bailinphil/kitchen-lights/wiring/kitchen-lights-wiring.kicad_pcb

## KiCad design STM32_KiCAD_Bluetooth/STM32_KiCAD_Bluetooth.kicad_sch

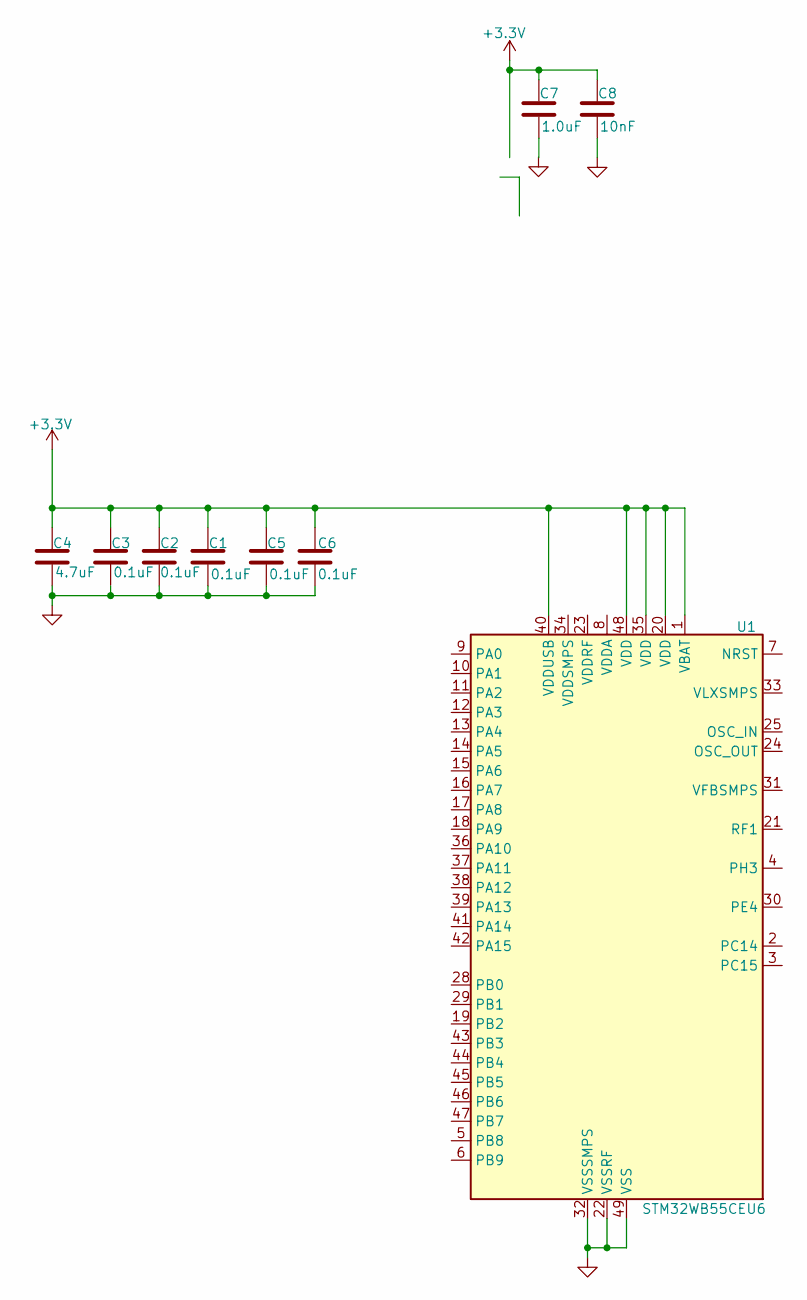
[picture p1: schematic STM32_KiCAD_Bluetooth.kicad_sch]

Parts:
C1, C2, C3, C5, C6: 0.1uF; C_0603_1608Metric; Voltage 25V; Tolerance 20%
C4: 4.7uF; C_0603_1608Metric; Voltage 35V; Tolerance 20%
C7: 1.0uF; C_0603_1608Metric; Voltage 16V; Tolerance 10%
C8: 10nF; C_0603_1608Metric; Voltage 16V; Tolerance 10%
U1: STM32WB55CEU6; QFN-48-1EP_7x7mm_P0.5mm_EP5.6x5.6mm

Connections:
+3.3V: C1.1, C2.1, C3.1, C4.1, C5.1, C6.1, C7.1, C8.1, U1.1 (VBAT), U1.20 (VDD), U1.35 (VDD), U1.40 (VDDUSB), U1.48 (VDD)
GND: C1.2, C2.2, C3.2, C4.2, C5.2, C6.2, C8.2, U1.22 (VSSRF), U1.32 (VSSSMPS), U1.49 (VSS)
