bailinphil/kitchen-lights/src/lights/licenses.h

#ifndef KITCHEN_LIGHTS_LICENSES_H_
#define KITCHEN_LIGHTS_LICENSES_H_

/*
 * LCD
 *
 * Sample Code Original Header
 *
 */

/*
 OpenLCD is an LCD with Serial/I2C/SPI interfaces.
 By: Nathan Seidle
 SparkFun Electronics
 Date: April 19th, 2015
 License: This code is public domain but you buy me a beer if you use this and we meet someday (Beerware license).
 This is example code that shows how to send data over I2C to the display.
 Note: This code expects the display to be listening at the default I2C address. If your display is not at 0x72, you can
 do a hardware reset. Tie the RX pin to ground and power up OpenLCD. You should see the splash screen
 then "System reset Power cycle me" and the backlight will begin to blink. Now power down OpenLCD and remove
 the RX/GND jumper. OpenLCD is now reset.
 To get this code to work, attached an OpenLCD to an Arduino Uno using the following pins:
 SCL (OpenLCD) to A5 (Arduino)
 SDA to A4
 VIN to 5V
 GND to GND
 Command cheat sheet:
 ASCII / DEC / HEX
 '|'    / 124 / 0x7C - Put into setting mode
 Ctrl+c / 3 / 0x03 - Change width to 20
 Ctrl+d / 4 / 0x04 - Change width to 16
 Ctrl+e / 5 / 0x05 - Change lines to 4
 Ctrl+f / 6 / 0x06 - Change lines to 2
 Ctrl+g / 7 / 0x07 - Change lines to 1
 Ctrl+h / 8 / 0x08 - Software reset of the system
 Ctrl+i / 9 / 0x09 - Enable/disable splash screen
 Ctrl+j / 10 / 0x0A - Save currently displayed text as splash
 Ctrl+k / 11 / 0x0B - Change baud to 2400bps
 Ctrl+l / 12 / 0x0C - Change baud to 4800bps
 Ctrl+m / 13 / 0x0D - Change baud to 9600bps
 Ctrl+n / 14 / 0x0E - Change baud to 14400bps
 Ctrl+o / 15 / 0x0F - Change baud to 19200bps
 Ctrl+p / 16 / 0x10 - Change baud to 38400bps
 Ctrl+q / 17 / 0x11 - Change baud to 57600bps
 Ctrl+r / 18 / 0x12 - Change baud to 115200bps
 Ctrl+s / 19 / 0x13 - Change baud to 230400bps
 Ctrl+t / 20 / 0x14 - Change baud to 460800bps
 Ctrl+u / 21 / 0x15 - Change baud to 921600bps
 Ctrl+v / 22 / 0x16 - Change baud to 1000000bps
 Ctrl+w / 23 / 0x17 - Change baud to 1200bps
 Ctrl+x / 24 / 0x18 - Change the contrast. Follow Ctrl+x with number 0 to 255. 120 is default.
 Ctrl+y / 25 / 0x19 - Change the TWI address. Follow Ctrl+x with number 0 to 255. 114 (0x72) is default.
 Ctrl+z / 26 / 0x1A - Enable/disable ignore RX pin on startup (ignore emergency reset)
 '-'    / 45 / 0x2D - Clear display. Move cursor to home position.
        / 128-157 / 0x80-0x9D - Set the primary backlight brightness. 128 = Off, 157 = 100%.
        / 158-187 / 0x9E-0xBB - Set the green backlight brightness. 158 = Off, 187 = 100%.
        / 188-217 / 0xBC-0xD9 - Set the blue backlight brightness. 188 = Off, 217 = 100%.
 For example, to change the baud rate to 115200 send 124 followed by 18.
*/

/*
  LiquidCrystal Library - Custom Characters

 Demonstrates how to add custom characters on an LCD  display.
 The LiquidCrystal library works with all LCD displays that are
 compatible with the  Hitachi HD44780 driver. There are many of
 them out there, and you can usually tell them by the 16-pin interface.

 This sketch prints "I <heart> Arduino!" and a little dancing man
 to the LCD.

  The circuit:
 * LCD RS pin to digital pin 12
 * LCD Enable pin to digital pin 11
 * LCD D4 pin to digital pin 5
 * LCD D5 pin to digital pin 4
 * LCD D6 pin to digital pin 3
 * LCD D7 pin to digital pin 2
 * LCD R/W pin to ground
 * 10K potentiometer:
 * ends to +5V and ground
 * wiper to LCD VO pin (pin 3)
 * 10K poterntiometer on pin A0

 created 21 Mar 2011
 by Tom Igoe
 modified 11 Nov 2013
 by Scott Fitzgerald
 modified 7 Nov 2016
 by Arturo Guadalupi

 Based on Adafruit's example at
 https://github.com/adafruit/SPI_VFD/blob/master/examples/createChar/createChar.pde

 This example code is in the public domain.
 http://www.arduino.cc/en/Tutorial/LiquidCrystalCustomCharacter

 Also useful:
 http://icontexto.com/charactercreator/

*/


/*
 * SparkFun Qwiic Twist
 *
 * Sample code original header
 *
 */
/*
  Read and interact with the SparkFun Qwiic Twist digital RGB encoder
  By: Nathan Seidle
  SparkFun Electronics
  Date: December 3rd, 2018
  License: MIT. See license file for more information but you can
  basically do whatever you want with this code.

  This example shows how to set the knob color to pink. This value is stored in the 
  Qwiic Twist and will be loaded after each power-on.

  Also - the max I2C datarate for Qwiic Twist is 400kHz
  
  Feel like supporting open source hardware?
  Buy a board from SparkFun! https://www.sparkfun.com/products/15083

  Hardware Connections:
  Plug a Qwiic cable into the Qwiic Twist and a BlackBoard
  If you don't have a platform with a Qwiic connection use the SparkFun Qwiic Breadboard Jumper (https://www.sparkfun.com/products/14425)
  Open the serial monitor at 115200 baud to see the output
*/


/**
 * BasicHTTPClient.ino
 *
 *  Created on: 24.05.2015
 *
 */

 /*
 * I2C-Generator: 0.3.0
 * Yaml Version: 2.1.3
 * Template Version: 0.7.0-112-g190ecaa
 */
/*
 * Copyright (c) 2021, Sensirion AG
 * All rights reserved.
 *
 * Redistribution and use in source and binary forms, with or without
 * modification, are permitted provided that the following conditions are met:
 *
 * * Redistributions of source code must retain the above copyright notice, this
 *   list of conditions and the following disclaimer.
 *
 * * Redistributions in binary form must reproduce the above copyright notice,
 *   this list of conditions and the following disclaimer in the documentation
 *   and/or other materials provided with the distribution.
 *
 * * Neither the name of Sensirion AG nor the names of its
 *   contributors may be used to endorse or promote products derived from
 *   this software without specific prior written permission.
 *
 * THIS SOFTWARE IS PROVIDED BY THE COPYRIGHT HOLDERS AND CONTRIBUTORS "AS IS"
 * AND ANY EXPRESS OR IMPLIED WARRANTIES, INCLUDING, BUT NOT LIMITED TO, THE
 * IMPLIED WARRANTIES OF MERCHANTABILITY AND FITNESS FOR A PARTICULAR PURPOSE
 * ARE DISCLAIMED. IN NO EVENT SHALL THE COPYRIGHT HOLDER OR CONTRIBUTORS BE
 * LIABLE FOR ANY DIRECT, INDIRECT, INCIDENTAL, SPECIAL, EXEMPLARY, OR
 * CONSEQUENTIAL DAMAGES (INCLUDING, BUT NOT LIMITED TO, PROCUREMENT OF
 * SUBSTITUTE GOODS OR SERVICES; LOSS OF USE, DATA, OR PROFITS; OR BUSINESS
 * INTERRUPTION) HOWEVER CAUSED AND ON ANY THEORY OF LIABILITY, WHETHER IN
 * CONTRACT, STRICT LIABILITY, OR TORT (INCLUDING NEGLIGENCE OR OTHERWISE)
 * ARISING IN ANY WAY OUT OF THE USE OF THIS SOFTWARE, EVEN IF ADVISED OF THE
 * POSSIBILITY OF SUCH DAMAGE.
 */

 /*
  Reading CO2, humidity and temperature from the SCD4x
  By: Paul Clark
  Based on earlier code by: Nathan Seidle
  SparkFun Electronics
  Date: June 3rd, 2021
  License: MIT. See license file for more information but you can
  basically do whatever you want with this code.

  Feel like supporting open source hardware?
  Buy a board from SparkFun! https://www.sparkfun.com/products/18365

  This example prints the current CO2 level, relative humidity, and temperature in C.

  Hardware Connections:
  Attach RedBoard to computer using a USB cable.
  Connect SCD40/41 to RedBoard using Qwiic cable.
  Open Serial Monitor at 115200 baud.
*/

/******************************************************************************
  Example1_BasicReadings.ino
  
  Read human presence detection values from the STHS34PF80 sensor, print them
  to terminal. Prints raw IR presence (cm^-1), if motion was detected, and 
  temperature in degrees C.

  SparkFun STHS34PF80 Arduino Library
  Madison Chodikov @ SparkFun Electronics
  Original Creation Date: September 19th, 2023
  https://github.com/sparkfun/SparkFun_STHS34PF80_Arduino_Library

  Development environment specifics:

  IDE: Arduino 2.2.1
  Hardware Platform: SparkFun RedBoard Qwiic	
  SparkFun Human Presence and Motion Sensor - STHS34PF80 (Qwiic) Version: 1.0
  SparkFun Qwiic Mini Human Presence and Motion Sensor - STHS34PF80 Version: 1.0

  Do you like this library? Help support SparkFun. Buy a board!

    SparkFun Human Presence and Motion Sensor - STHS34PF80 (Qwiic)
    https://www.sparkfun.com/products/22494
    
    SparkFun Qwiic Mini Human Presence and Motion Sensor - STHS34PF80
    https://www.sparkfun.com/products/23253

  Hardware Connections:
  Use a Qwiic cable to connect from the RedBoard Qwiic to the STHS34PF80 breakout (QWIIC).
  You can also choose to wire up the connections using the header pins like so:

  ARDUINO --> STHS34PF80
  SDA (A4) --> SDA
  SCL (A5) --> SCL
  3.3V --> 3.3V
  GND --> GND

  This program is distributed in the hope that it will be useful,
  but WITHOUT ANY WARRANTY; without even the implied warranty of
  MERCHANTABILITY or FITNESS FOR A PARTICULAR PURPOSE. See the
  GNU General Public License for more details.

  You should have received a copy of the GNU General Public License
  along with this program.  If not, see <http://www.gnu.org/licenses/>.
******************************************************************************/

#endif  // KITCHEN_LIGHTS_LICENSES_H_
