bailinphil/kitchen-lights/(commit log)

2025-01-25 initial project setup, including some Arduino code which runs simple exercises on a SparkFun ESP32 IoT Redboard
    [kitchen-lights-wiring.kicad_pcb, kitchen-lights-wiring.kicad_sch]
2025-01-26 added some logic to color the twist wheel orange as you turn it.
2025-01-29 fetch the current time in UTC
    The WiFi example code in the library included an example of fetching
    the current time from time.nist.gov. I modified this to fetch from
    time.google.com instead, and I moved the network credentials to a
    separate file to avoid committing them to the repository.
    This example seems to take up about 70% of the available storage on
    my device; I hope that the other libraries I want to use don't make
    it take up more than I have available! Or that I can use the SD
    card slot to store a larger program on my device.
    [get_time.ino]
2025-02-15 ignore the Arduino/libraries directory
2025-02-17 rename Arduino directory as src; move existing prototype and example code to a references/ folder within src.
2025-02-17 Specify correct color order for my particular LEDs.
    [two_light_outputs.ino]
2025-02-17 begin to lay out actual project code
    up until now, I have been working with a number of examples and simple demos
    of each individual component of the system. Now it is time to begin working
    on the real interface and behavior that the final installation will have,
    featuring:
    1. Mode selection dial with 10 positions
    2. Qwiic Twist for various knob-and-button-based adjustments
    3. Internet connection to get time, save and fetch custom adjustments
    4. Human presence sensor to time the lights out when no one is there
    5. 16x2 LCD display to communicate status and other information
    6. Air quality metrics
    A. Logging the data to my personal web server.
    7. I am considering a photoresistor to se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
2025-02-17 WiFi IPV6 code which fetches the time
    This code works as is, but includes some very long delays, which
    means that all of the other inputs on the rotary switch and the
    twist have a ~10s wait to see the result. Obviously, this won't
    do.
    The next step is to redesign the WiFi loop function to always
    end quickly and check the elapsed time instead of forcing the
    main thread to idle for long periods.
    [lights.ino]
2025-02-18 Fetch, parse, display weather data. Don't flicker the LCD.
    This update hits an endpoint on my personal web server which
    periodically fetches current weather data and prepares it for display on
    the 16x2. The RedBoard will go fetch that file, parse it, and
    rotate through the info that it wants to report.
2025-12-20 add human presence sensor to the i2c chain, make it active during night mode
2025-12-20 add example for using MicroSD card slot on IoT RedBoard
2025-12-21 Track 2 previous mode values and use them to ignore analog noise.
    While testing "night" mode, I noticed that occasionally the lights
    would flicker briefly because they were flashing for one moment into
    a mode with nearby adjacent analog values for the switch. That is,
    every once in a while the analog read values for the switch would be
    slightly out of range. In order to resolve this, I keep a small
    buffer of the previous two readings. This allows me to ignore an
    isolated value which is out of range and doesn't reflect an actual
    switch.
    [lights.ino]
2025-12-21 Begin taking readings with the SEN-25200 indoor air quality sensor.
    This code is lifted verbatim from the examples provided with the
    arduino library for the sensor.
2025-12-27 Implement a "sliding window" brightness control
    The Twist Rotational input can boot up with "any" value to start.
    As you spin the dial, the original algorithm was computing brightness
    and then limiting it to 0-255. But you could keep going outside of
    the range, and you couldn't go the opposite direction until you
    went all the way back to within the range.
    This is solved by making a sliding window: if you are already at
    the maximum brightness, turning the dial clockwise will slide the
    window up. So when you turn the dial counterclockwise, the brightness
    will immediately start to reduce. This feels more intuitive.
    [licenses.h, lights.ino]
2025-12-28 Talk to a third pin of lights. This was mostly wiring work.
2026-03-12 Refactor lights.ino for readability without functional changes
    - Reformat modeName[], twist_colors[][], and modeColor[] arrays with
    consistent indentation, trailing commas, and inline mode-name comments
    so the three parallel arrays are easy to read and cross-reference
    - Extract updateTwistWindow() and applyNightFade() helpers from loop()
    to give descriptive names to the two dense logic blocks there
    - Simplify checkPresence() with early returns, removing the redundant
    local `result` variable
    - Rename shadowing local `presenceVal` in loop() to `detectedPresence`
    - Make getSwitchPosition() consistent: declare variables at top, assign
    val before color in every branch
    - Fix charsPrinted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
    [lights.ino]
2026-03-12 Rename helpers and reorganize into labeled subsystem sections
    Renames:
    - setup16x2 → setupDisplay
    - setupSensiron41 → setupCO2Sensor
    - setupSensiron55 → setupParticulateSensor
    - loopAirQuality → reportAirQuality
    - i2cSendValue → updateDisplay
    - fill → setAllLEDs
    - updateTwistWindow → clampTwistWindow
    Layout (top to bottom):
    1. SETUP – setup() + all setupX() helpers + printSerialNumber/printModuleVersions
    (diagnostic print helpers moved next to the setup code that calls them)
    2. LOOP – loop() entry point
    3. DISPLAY – prepareTopMessage, prepareBottomMessage, updateDisplay
    4. LEDS – setAllLEDs
    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
2026-03-14 wrap air quality sensor-related code in #define to allow disconnection
    add a series of #define directives which allow me to compile the code with any of the hardware devices connected or disabled.
    Let's start by making a #define called IS_AIR_SENSOR_PRESENT which I can give a value of true or false to. If it is true, I want the corresponding setup functions (setupC02Sensor, setupParticulateSensor) to be enabled. otherwise, skip them.
    Likewise, in the main loop() I want all of the code which checks for how long it's been since an air report to be enabled or disabled by IS_AIR_SENSOR_PRESENT.
    [lights.ino]
2026-03-15 Create constant for mode switch pin, turn twist back on for testing.
2026-03-15 Add a #define to disable the presence sensor
2026-03-15 add a #define to disable the LEDs
2026-03-15 working on solving a problem with serial output.
    1. try activating and deactivating various components
    - Currently, if WiFi is enabled but FastLED is not, we get an
    exception that I don't understand yet.
    2. I've connected the problem with Serial output with FastLED.
    - https://forum.arduino.cc/t/fastled-causes-serial-data-corruption-thoughts/669299/6
    - I made a first (flawed) attempt to follow the advice in there of
    not calling FastLED.show() more than necessary. It helps, by
    reducing the spam to the Serial connection. However, the other
    calls to Serial.println() are still not getting through.
    [lights.ino]
2026-03-15 Move FastLED communication off of the default Serial I/O pins.
    Response from Claude when I had asked it for assistance with debugging:
    Looking at the code, I think there's a **direct hardware conflict** that's almost certainly the smoking gun here. Let me point it out:
    ```cpp
    FastLED.addLeds<CHIPSET, 3, COLOR_ORDER>(leds, NUM_LEDS);
    FastLED.addLeds<CHIPSET, 1, COLOR_ORDER>(leds, NUM_LEDS); // ← PIN 1
    FastLED.addLeds<CHIPSET, 4, COLOR_ORDER>(leds, NUM_LEDS);
    ```
    On the ESP32, the default hardware serial pins are:
    - **GPIO 1 = TX** (Serial transmit)
    - **GPIO 3 = RX** (Serial receive)
    You're driving two of your three LED strips on **pins 1 and 3** — the exact same pins that `Serial` us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
2026-03-16 Fix several bugs likely causing the 16x2 display to freeze after hours of uptime
    - Fix off-by-one in prepareBottomMessage: `> WEATHER_REPORT_MAX_LENGTH` should
    be `>=`, otherwise weatherReport[10] is accessed out-of-bounds every ~30s,
    causing repeated heap corruption that accumulates over time.
    - Add bounds check in parseWeatherReport to prevent writing past the end of
    the weatherReport array if the server returns more tokens than expected.
    - Fix millisWhenBottomRowUpdated declared as int instead of unsigned long;
    it stores the return value of millis() and would overflow after ~24.8 days.
    - Move millisWhenWeatherLastFetched update outside the HTTP_CODE_OK check so
    failed fetches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
    [lights.ino]
2026-03-17 Implement the de-noise logic for mode switch as a delay time instead of majority vote.
    This addresses [Issue #12](https://github.com/bailinphil/kitchen-lights/issues/12).
    [lights.ino]
2026-03-17 Guard the assignment of isLedDirty inside of #IS_FASTLED_ENABLED
    This (and 8eddfa8f20aef20f791faede2df0a60ab81cb570) address https://github.com/bailinphil/kitchen-lights/issues/1
    [lights.ino]
2026-03-17 Add multi-region LED setup for under-cabinet and ceiling runs
    Replace the single shared LED array with per-pin arrays and named
    region constants (placeholder sizes) for under-cabinet sections
    (pin 25) and ceiling sections (pins 17, 16). Under-cabinet and
    ceiling pin 17 are reversed in software to allow logical left-to-right
    addressing despite right-to-left wiring. The ceiling strips are
    treated as one continuous run so future animations can flow seamlessly
    across both pins.
    Closes #3
    [lights.ino]
2026-03-17 Implement Rainbow mode replacing Racetrack
    Rename mode index 7 from "Racetrack" to "Rainbow" and add a
    continuously animated effect that propagates fully-saturated colors
    left-to-right across both the under-cabinet and ceiling runs.
    - Each loop iteration, shift all LEDs one position right and inject
    the current hue at the leftmost end (~3 second full traversal).
    - Ceiling crossover: pin 17 flows seamlessly into pin 16.
    - Twist knob controls hue instead of brightness while in Rainbow mode.
    - Twist button toggles between auto-cycling hue and manual selection.
    - Entering Rainbow mode picks a random starting hue and clears strips.
    Closes #8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
2026-03-17 Fix Rainbow mode compile error: use committedSwitchPosition for twist button
    The twist button press handler runs before getDebouncedSwitchPosition(),
    so nextSwitchPosition is not yet declared. Use the already-committed
    global instead.
    [lights.ino]
2026-03-17 Implement Twinkle mode with spawn collision avoidance and blue-green palette
    Twinkle mode (index 8) spawns random colored spots that fade in, spread
    to neighbors, then decay via global fadeToBlackBy. Palette is limited to
    blue-green hues to avoid jarring clashes between adjacent spots. New
    spawns avoid positions near still-bright active spots. Twist knob
    controls spawn rate (2-30/sec), twist button (isClicked) toggles
    monochrome vs multi-color.
    Closes #9
    [lights.ino]
2026-03-18 Implement Fire mode replacing Sparkles with heat-map fire simulation
    Add a heat-diffusion fire effect on mode index 6. Each strip maintains
    a heat array that cools, drifts upward, and randomly sparks near the
    source end each frame. Heat values are mapped to color via HeatColor
    (warm) or a blue-swapped variant (cool). The twist knob controls
    sparking intensity and the button toggles warm/cool palettes. Simulation
    is throttled to 15ms frames for a mellow flicker.
    Closes #7
    [lights.ino]
2026-03-18 Add presence-based fade-in and rename fade functions to be mode-agnostic
    Implement gentle fade-in when presence is detected while lights are off,
    complementing the existing fade-out. Rename Night-specific identifiers
    (applyNightFade, millisTimeoutAtNight) to generic presence-based names
    (applyPresenceFade, millisPresenceTimeout) so the behavior can be reused
    across modes.
    Closes #2, closes #13
2026-03-18 Fix sunset time never appearing in weather display
    parseWeatherReport() only captured tokens when hitting a '|' delimiter,
    so the final token (Sunset) was always dropped. Add a post-loop capture
    for the trailing segment. The tokenStart < raw.length() guard safely
    ignores empty trailing tokens if the server ever adds a trailing '|'.
    Closes #15
    [lights.ino]
2026-03-18 Implement Routine mode with time-based lighting and presence fade
    Routine mode now automatically selects a lighting behavior based on the
    current time relative to sunrise and sunset:
    - 1h before sunrise → Dishes
    - sunrise+30m → Cook Day
    - 1h before sunset → Cook Night
    - sunset → Dishes
    - 1h after sunset → Night
    Presence detection is applied in Routine mode with a 60-second timeout
    (vs 20s for Night mode). applyPresenceFade() now accepts an optional
    timeout parameter so the same logic serves both modes.
    Closes #5
2026-03-18 Fix presence sensor false positives by requiring motion corroboration
    The presence flag alone is prone to false positives from ambient
    temperature drift. Now require both pres_flag and mot_flag to be set
    before counting a detection, matching the approach in the SparkFun
    sample code.
    Fixes #16
    [lights.ino]
2026-03-20 Fix I2C bus instability causing display errors and sensor CRC failures
    - Initialize Wire bus once in setup() before any device, preventing
    libraries from reinitializing with conflicting settings
    - Throttle presence sensor polling to every 150ms (was every 5ms loop)
    - Add error handling to all presence sensor I2C calls
    - Split display clear/write into separate I2C transactions with 10ms gap
    - Add 2s cooldown on failed display writes to prevent retry storms
    - Add 1s post-reset delay for SEN55 to fix CRC errors on boot
    - Stagger I2C device setup with 50ms gaps between inits
    - Add 1ms gaps between I2C device accesses in main loop
    Closes #17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
    [lights.ino]
2026-03-20 Guard Wire.begin() on any I2C device, not just the display
    Wire.begin() was gated on IS_DISPLAY_ENABLED, so disabling the display
    would silently break all other I2C devices. Add IS_I2C_BUS_ENABLED as
    a logical OR of all I2C-using components and use it for the bus init
    and Wire.h include.
2026-03-20 try to make sure code compiles with any permutation of hardware enabled
    In addition, I also peformed a few cleanups:
    1. move the delay(5) to the beginning of the loop instead of the end,
    because there are a few time-sensitive operations there and it's
    easier to read with those logics clustered.
    2. remove the #define USE_SERIAL which didn't match the way I addressed
    Serial in the rest of the file
    3. select better millisecond delays for weather and air reports, trying
    to avoid having them both hit on the same time through loop(). Add
    a boolean to ensure that they really don't occur at the same time.
    [lights.ino]
2026-03-21 Work on making the c++ code adhere to Google style guide.
    There's nothing particularly special about the Google style guide, I could
    have chosen any reasonably complete guide. I just wanted to make the code
    follow a consistent style and any reasonably comprehensive and well-considered
    style would meet my goals.
    This gigantic commit should consist almost entirely of variable and function
    renames, as well as some bracket styling. However, in testing, I appear to see
    a reoccurence of #17, so I am conducting some additional testing to evaluate
    whether this work has accidentally broken something.
    [licenses.h, lights.ino]
2026-03-28 Convert #define constants to constexpr with kCamelCase naming per Google style guide.
    Also fix three if-statement brace placements to use same-line style,
    and move presence sensor to Wire1 on dedicated GPIO 26/27.
    [lights.ino]
2026-03-28 I designed a little board to mount all of the main electrical components.
    This board will be mounted under the rightmost cabinet in the room. It
    gives a secure mounting place for the ESP32 board, the air quality sensor,
    the presence sensor, three LED signal amplifiers, and some electrical buses
    to power everything.
    I cut this out of thick draftboard on the laser cutter and mounted all of
    the components. They all mounted just as planned. Another day, I'll cut a
    plexiglass shield to keep it safe from basic splatters.
2026-04-12 Add the outlines of a shield for the under-cabinet mounting
    The main brain, air quality sensor, presence sensor, and LED signal
    amplifiers are all going to be mounted on the underside of my kitchen
    cabinets. They could use some protection from bumps, liquids, and the
    like. Therefore, I designed a simple shield that I laser-cut out of
    acrylic to provide some coverage. The sides are open and there is also
    a hole for the air quality sensor to stick out of (I wanted the shield
    to be mostly hidden up under the cabinet, so as low profile as possible.)
2026-04-13 Move presence sensor to dedicated I2C bus (Wire1) on GPIO 4/13 and switch from polling to interrupt-driven reads
    - Change presence sensor pins from 26/27 to SDA=4, SCL=13
    - Configure STHS34PF80 INT pin (GPIO 14) to fire on presence or motion
    - Replace 150ms polling loop with ISR that sets a volatile flag
    - Remove getDataReady() I2C call since the interrupt signals data readiness
    - Reading the status register clears the interrupt latch automatically
    [lights.ino]
2026-04-13 Fix presence interrupt only firing once by using latched mode
    setInterruptPulsed(0) was pulsed, not latched — the brief ~75µs
    pulse was being swallowed by FastLED's interrupt blackout windows.
    Switch to setInterruptPulsed(1) for true latched mode so INT stays
    asserted until the status register is read. Also use FALLING trigger
    instead of CHANGE to avoid spurious ISR calls on the clearing edge.
    Re-add getDataReady() call to clear the DRDY flag so the sensor
    continues processing new measurements.
    [lights.ino]
2026-04-13 Add some minor details to current weather reporting
    This update looks 15 minutes into the future for a "current" rain
    prediction and makes a few other minor edits. I had done this work
    months ago and not committed it.
2026-04-14 Fix display lag when switching modes (#19)
    Reset the display retry timer on mode change so the LCD refreshes
    immediately instead of waiting up to 2s for the I2C retry window.
    [lights.ino]
2026-04-14 Split lights.ino into three files for navigability (#11)
    Extract loop() into loop.ino and all loop helpers (display, LEDs, input,
    presence, weather, air quality) into loop_helpers.ino. lights.ino retains
    declarations, constants, globals, and setup(). The primary .ino must
    contain at least one function definition to avoid an Arduino IDE
    preprocessor bug with #line directives.
    [lights.ino, loop.ino, loop_helpers.ino]
2026-04-14 Fix fade-in from darkness when presence is re-detected during fade-out (#20)
    When presence was re-detected mid-fade-out, the fade-in timer reset to
    now, causing lights to snap to darkness before ramping back up. The
    fade-in start is now backdated to match current brightness, giving a
    seamless transition. Also unifies the presence timeout to 2 minutes for
    both Night and Routine modes and extracts FadeOutBrightnessRatio to
    avoid duplicating the fade-out curve calculation.
    [lights.ino, loop.ino, loop_helpers.ino]
2026-07-03 Set real under-cabinet LED segment counts; document board outputs
    Replace the placeholder under-cabinet segment lengths with measured
    values and break the run into its actual physical segments (sink-right,
    over-sink, sink-left, stove) so kNumLedsPin25 reflects the real strip.
    Add wiring/outputs.md documenting the board's three outputs, their
    GPIOs, and configured LED counts — including a note that a strip lit to
    a clean round number (e.g. 50) is almost always plugged into the wrong
    output, not a strip/wiring/driver fault.
    Add a minimal FastLED-only isolation sketch used to confirm the LED
    driver works independently of the main firmware.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
    [led_isolation_test.ino, lights.ino]
2026-07-11 Move all network I/O to a dedicated FreeRTOS task
    Weather fetches and air-quality reports ran synchronously inside loop(),
    so a slow or failing HTTP request (e.g. a refused connection during a
    supply-voltage sag) stalled the whole render loop for seconds: presence
    went unnoticed and the knob and switch were unresponsive.
    Move all networking onto a dedicated FreeRTOS task pinned to core 0
    (loop() runs on core 1), so a failed or slow request can never block
    rendering or input. The task owns wifi_multi and every HTTPClient, so
    there is a single owner of the WiFi stack.
    Also:
    - Bound each request with short connect/read timeouts so a hung
    connection fails fast instead of relying on the SDK d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
    [lights.ino, loop.ino, loop_helpers.ino, network.ino]
2026-07-19 Fix weather/air fetches dying at the DNS record's TTL (#4)
    The device's clock froze and every network call failed with "connection
    refused" after a rock-consistent ~30 minutes, regardless of load. Serial
    instrumentation ruled out brownout, heap leak, fragmentation, stack
    starvation, and DHCP/IP loss (all healthy in the frozen state), and pinned
    the cause: WiFi.hostByName() returns success but resolves to 0.0.0.0 once
    the DNS record's TTL (~1800s) lapses, so connect() targets the null address
    forever. Not a power or memory problem at all.
    Fix: resolve the host once, cache the last-known-good server IP, and make
    requests straight to that IP — bypassing the flaky resolver in the request
    path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
    [lights.ino, loop_helpers.ino, network.ino]
2026-07-19 Set real ceiling-run LED counts (147 + 120)
    The ceiling run is two pins driven as one logical strip; the counts were
    still placeholder 50/50. Set them to the actual installed segment counts:
    147 on pin 17 (left, wired reversed) and 120 on pin 16 (right).
    [lights.ino]
2026-08-26 Recover the presence I2C bus on fault instead of wedging the loop
    Four sudden reboots in one day after extending the under-cabinet run: the
    16x2 re-initialized each time, and several landed in steady state — no mode,
    brightness, or color change — while standing in front of the presence sensor.
    Load-driven brownout doesn't fit: the same 450W supply had driven more LEDs
    for months on the bench, and the reboots came with LED current flat.
    The presence path was the common factor. The ISR itself is clean (it sets a
    volatile flag and nothing else), but CheckPresence() does its actual reads on
    the main loop over Wire1, and the Arduino Wire API gives you no way back from
    a bus that faults mid-t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
    [lights.ino, loop_helpers.ino]
2026-08-26 Distinguish the "presence detected" message from other serial outputs
    I have noticed in testing that the lights are activated while in routine mode
    more than I would have expected. I am unsure whether the motion sensor is now
    firing more than I'd expect. However, debugging this is tricky because I need
    to see the messages while connected to serial and standing out of range of
    the motion detection. making the "presence detected" message more visually
    distinct is intended to help make testing this case easier.
2026-09-21 Consolidate per-mode arrays into a single kModes table
    mode_name, mode_color, and twist_colors were three parallel arrays indexed
    by switch position, with the mode index constants scattered through the LED
    section and GetRoutineColor() reaching in with bare indices. Each mode is
    now one ModeInfo row, with all ten index constants declared beside the
    table and a static_assert tying the row count to the switch's positions.
    Names become const char* instead of heap-allocated Strings. FastLED.h is
    now included unconditionally because the table uses CRGB.
2026-09-21 Correct comments that describe the presence interrupt as latched
    setInterruptPulsed(1) selects pulsed mode: the INT pin pulses once per
    sample and releases on its own, rather than staying asserted until the
    status register is read.
    [lights.ino, loop_helpers.ino]
